hannes-hochreiner/kicad/models/CTS-FrequencyControls/CB3LV-3I-8M192000.step

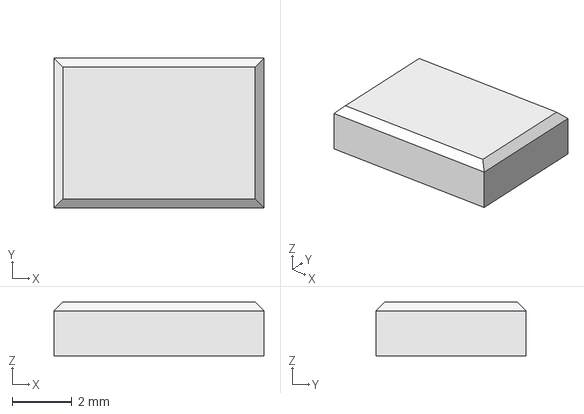
[picture p1: CAD file, 2021-01-03]
models/CTS-FrequencyControls/CB3LV-3I-8M192000.step
7.00 x 5.00 x 1.80 mm
