hannes-hochreiner/kicad/models/DiodesIncorporated/ZXCT1110W5-7.step

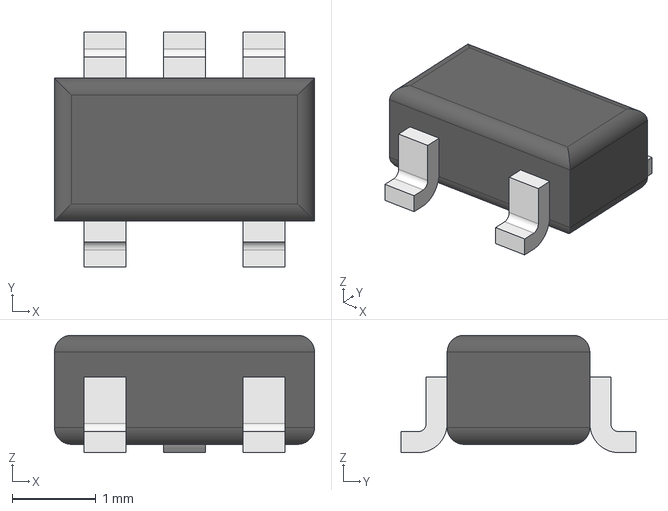
[picture p2: CAD file, 2020-11-29]
models/DiodesIncorporated/ZXCT1110W5-7.step
3.10 x 2.80 x 1.40 mm
