hannes-hochreiner/kicad/models/GCT/BD050-10.step

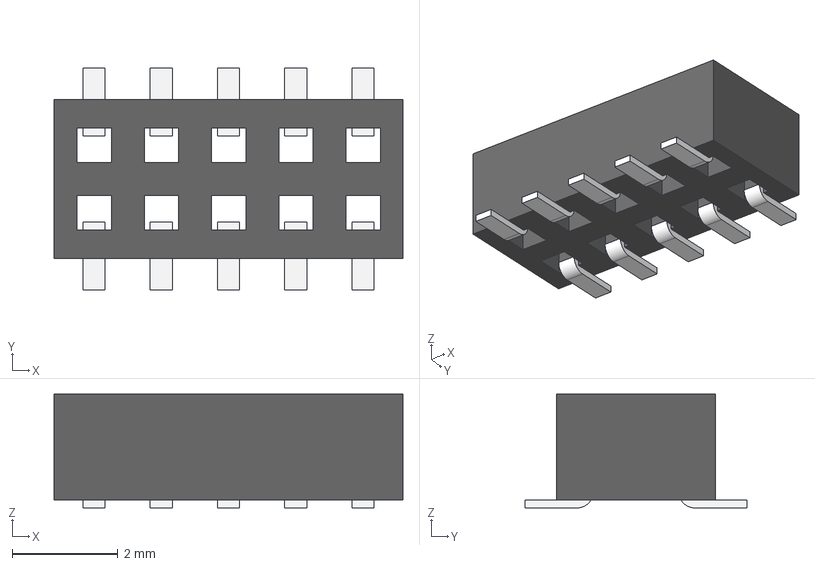
[picture p3: CAD file, 2021-06-03]
models/GCT/BD050-10.step
6.59 x 4.20 x 2.15 mm
