hannes-hochreiner/kicad/models/generic/crystal_3_2x1_5mm.step

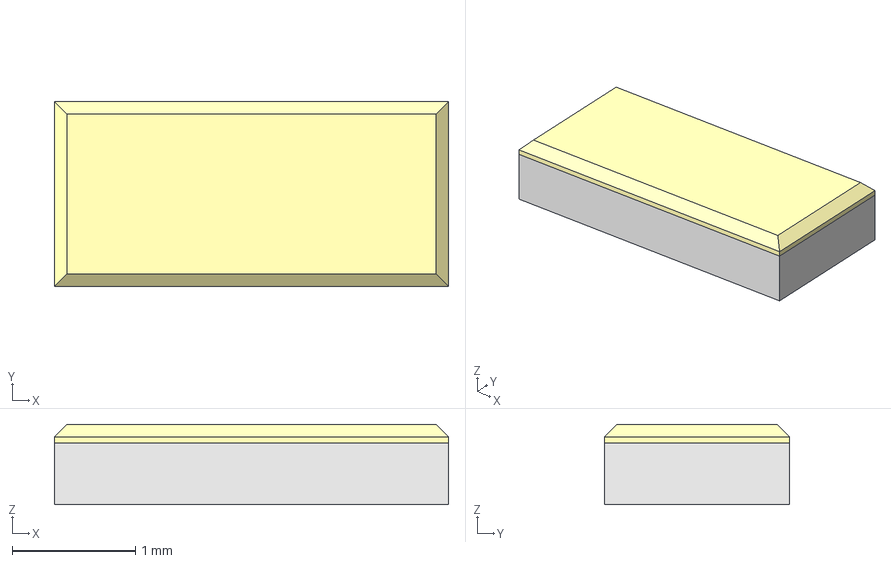
[picture p4: CAD file, 2021-06-03]
models/generic/crystal_3_2x1_5mm.step
3.20 x 1.50 x 0.65 mm
base
