hannes-hochreiner/kicad/models/HopeRF/RFM98.step

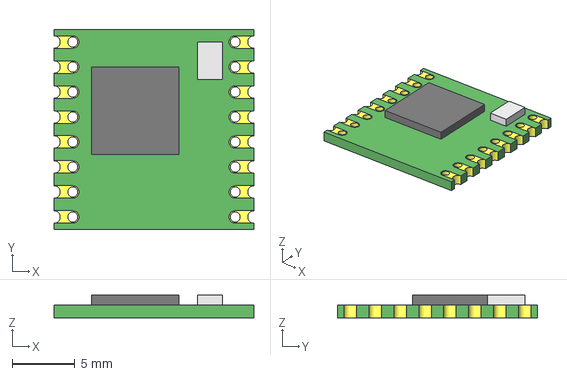
[picture p5: CAD file, 2019-08-25]
models/HopeRF/RFM98.step
16.0 x 16.0 x 1.80 mm
