hannes-hochreiner/kicad/models/Laird/BL651.step

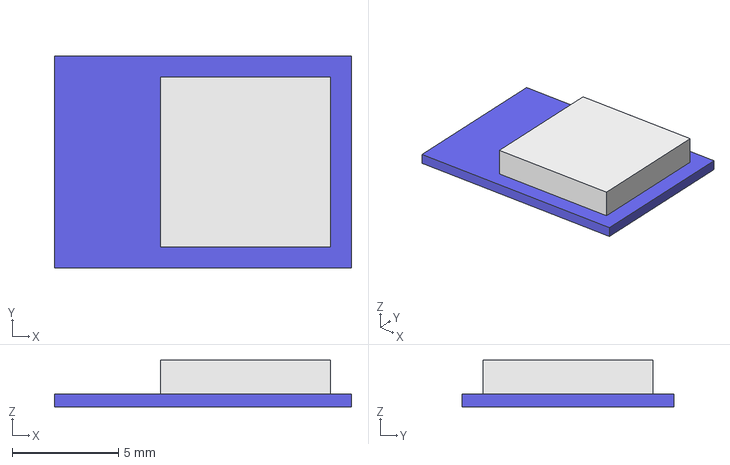
[picture p6: CAD file, 2020-10-26]
models/Laird/BL651.step
14.0 x 10.0 x 2.20 mm
