hannes-hochreiner/kicad/models/MicroCrystal/CM7V-T1A.step

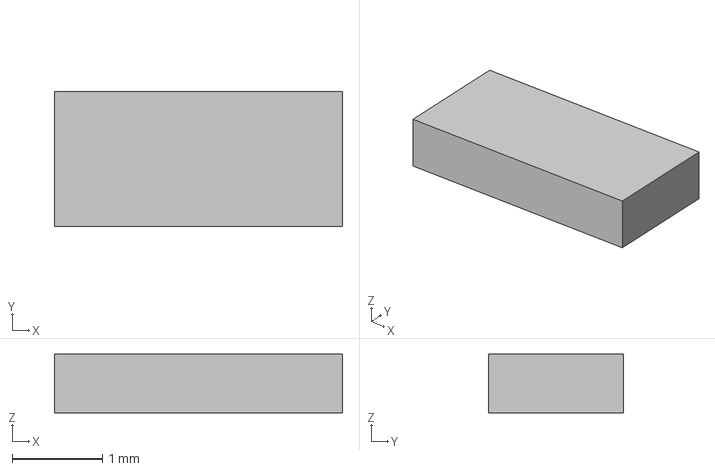
[picture p7: CAD file, 2020-11-29]
models/MicroCrystal/CM7V-T1A.step
3.20 x 1.50 x 0.65 mm
