hannes-hochreiner/kicad/models/SiTime/SIT1602BI-21-XXE-8.192000G.step

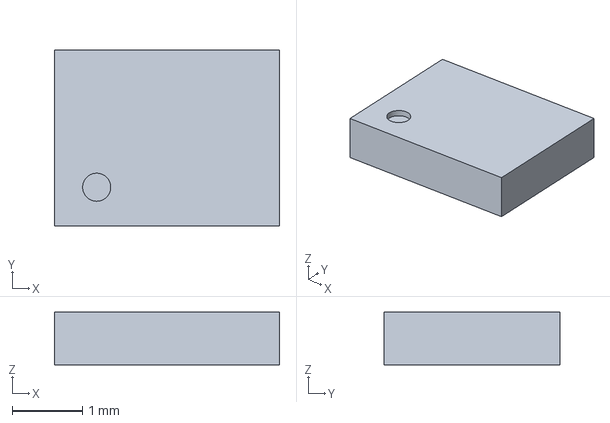
[picture p8: CAD file, 2020-11-29]
models/SiTime/SIT1602BI-21-XXE-8.192000G.step
3.20 x 2.50 x 0.75 mm
