hannes-hochreiner/kicad/models/STMicroelectronics/LSM303AGR.step

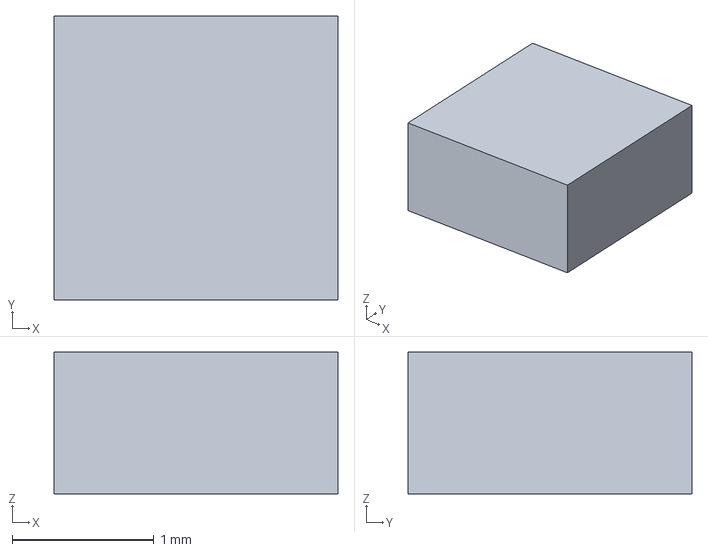
[picture p9: CAD file, 2021-06-03]
models/STMicroelectronics/LSM303AGR.step
2.00 x 2.00 x 1.00 mm
