hannes-hochreiner/kicad/models/TexasInstruments/TPS6031x.step

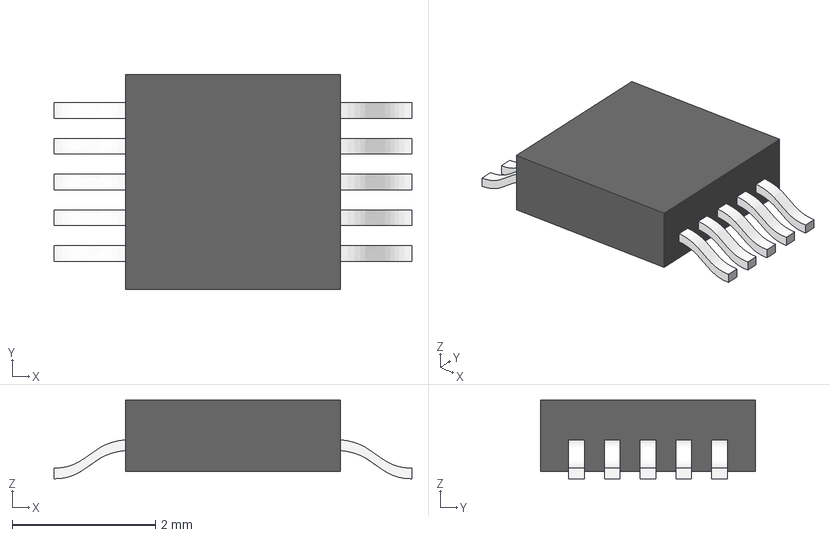
[picture p10: CAD file, 2021-06-03]
models/TexasInstruments/TPS6031x.step
5.00 x 3.00 x 1.10 mm
pin x 5
pin001 x 5
