hannes-hochreiner/kicad/models/GCT/BD050-06.step

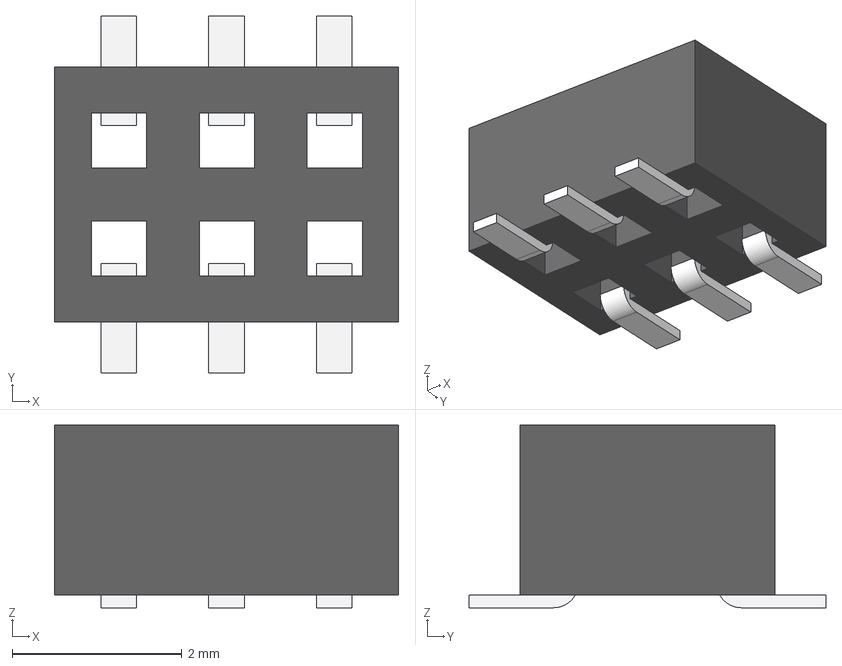
[picture p11: CAD file, 2021-06-03]
models/GCT/BD050-06.step
4.05 x 4.20 x 2.15 mm
