hannes-hochreiner/kicad/models/generic/R_2010.step

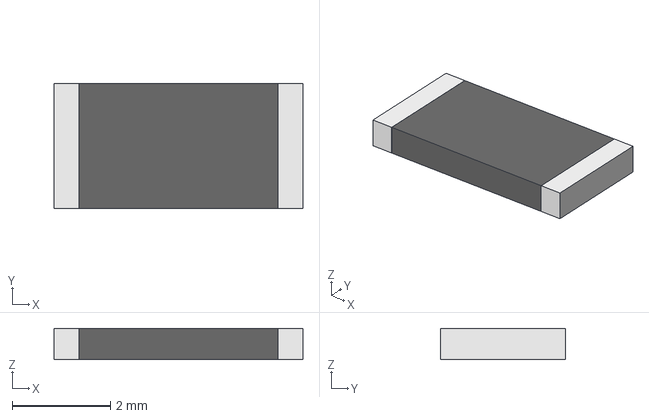
[picture p12: CAD file, 2021-01-03]
models/generic/R_2010.step
5.08 x 2.54 x 0.635 mm
