hannes-hochreiner/kicad/models/Memsic/MXC4005XC.step

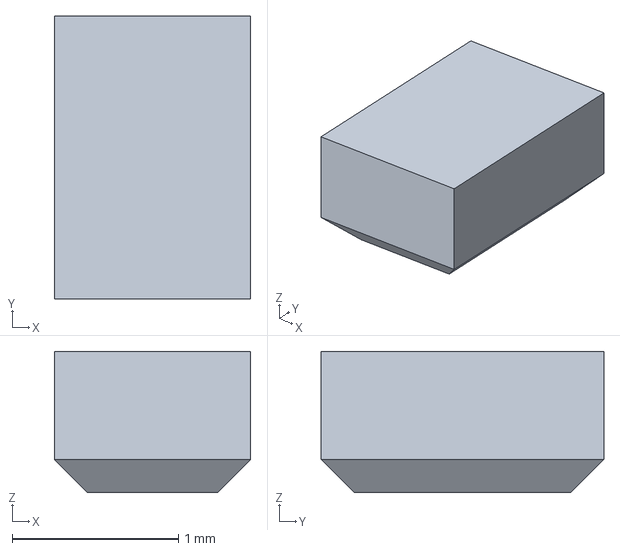
[picture p13: CAD file, 2021-06-03]
models/Memsic/MXC4005XC.step
1.18 x 1.70 x 0.85 mm
