hannes-hochreiner/kicad/models/Sensirion/SHTC3.step

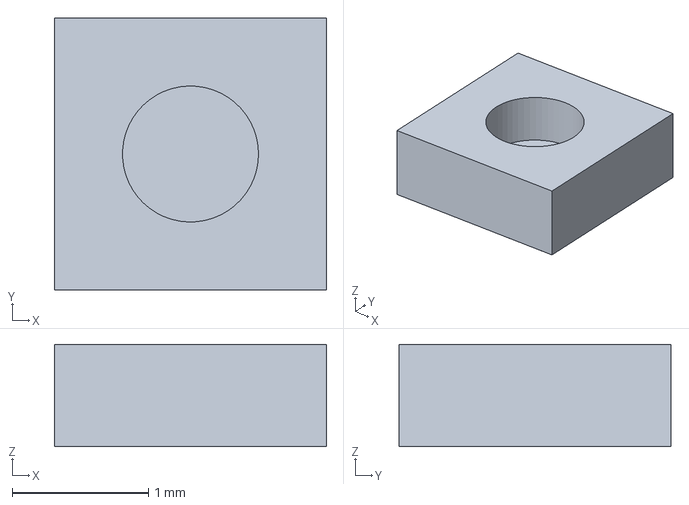
[picture p14: CAD file, 2020-11-29]
models/Sensirion/SHTC3.step
2.00 x 2.00 x 0.75 mm
