hannes-hochreiner/kicad/models/TexasInstruments/INA381-WSON.step

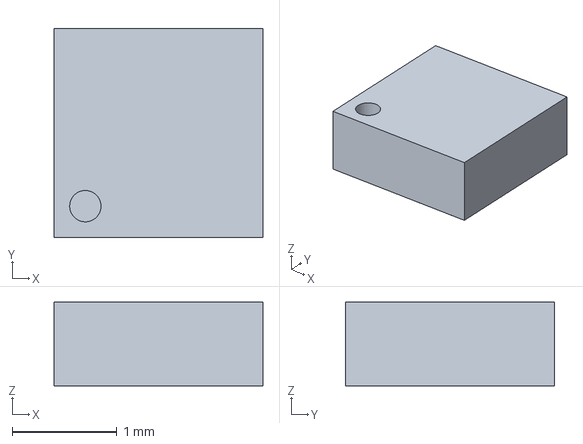
[picture p15: CAD file, 2021-01-03]
models/TexasInstruments/INA381-WSON.step
2.00 x 2.00 x 0.8 mm
