hannes-hochreiner/kicad/models/generic/R_0612.step

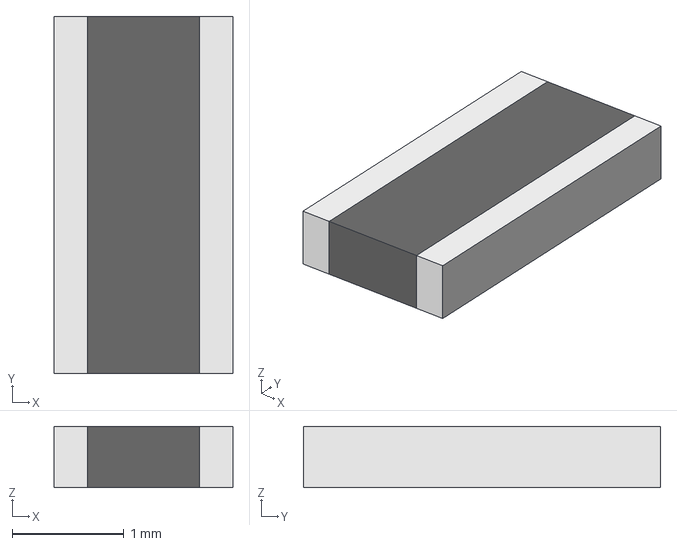
[picture p16: CAD file, 2021-01-03]
models/generic/R_0612.step
1.60 x 3.20 x 0.55 mm
