hannes-hochreiner/kicad/models/TexasInstruments/ADS131M04.step

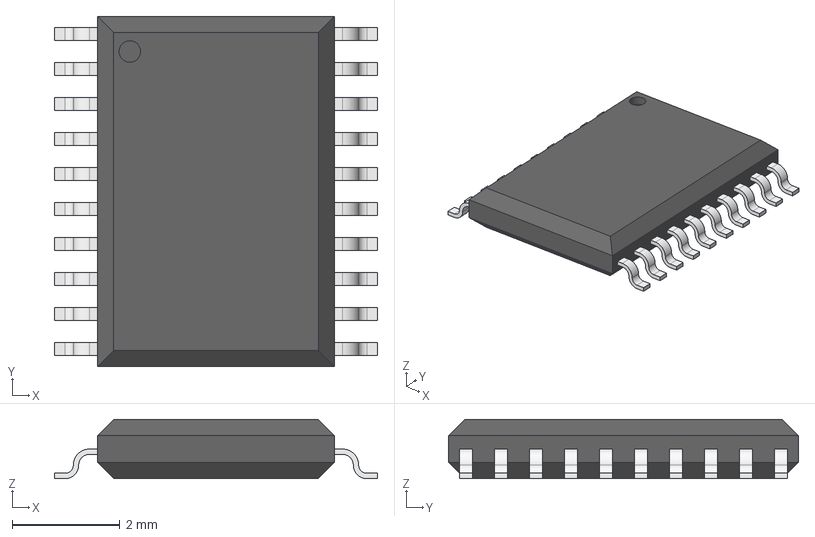
[picture p17: CAD file, 2021-01-03]
models/TexasInstruments/ADS131M04.step
6.00 x 6.50 x 1.10 mm
