hannes-hochreiner/kicad/models/generic/header_smd_2_54_2x5.step

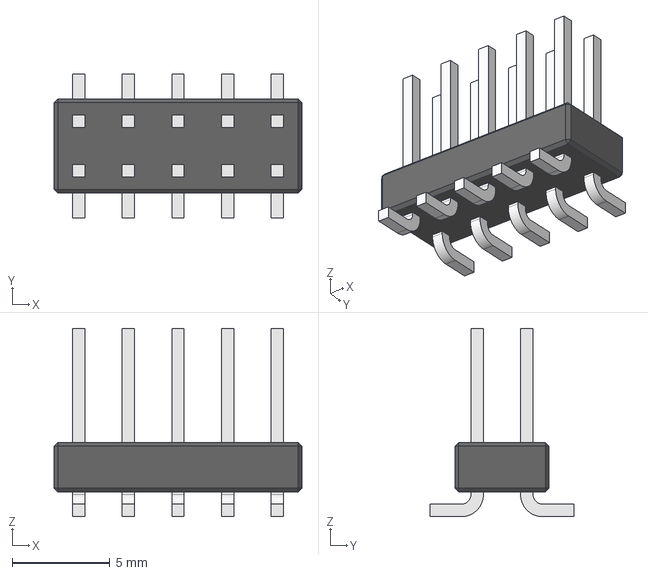
[picture p18: CAD file, 2021-01-03]
models/generic/header_smd_2_54_2x5.step
12.7 x 7.37 x 9.65 mm
