hannes-hochreiner/kicad/models/generic/header_smd_2_54_2x2.step

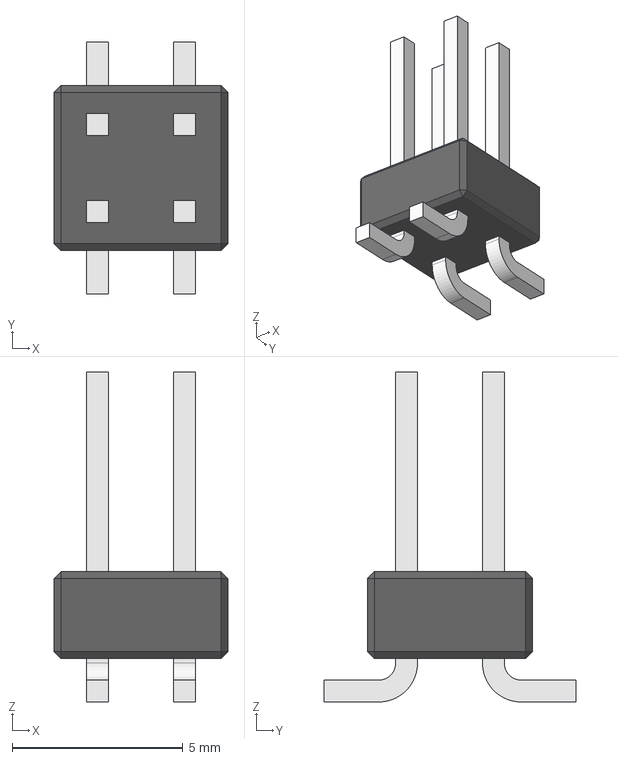
[picture p19: CAD file, 2021-01-03]
models/generic/header_smd_2_54_2x2.step
5.08 x 7.37 x 9.65 mm
