hannes-hochreiner/kicad/models/generic/Battery_AAA.step

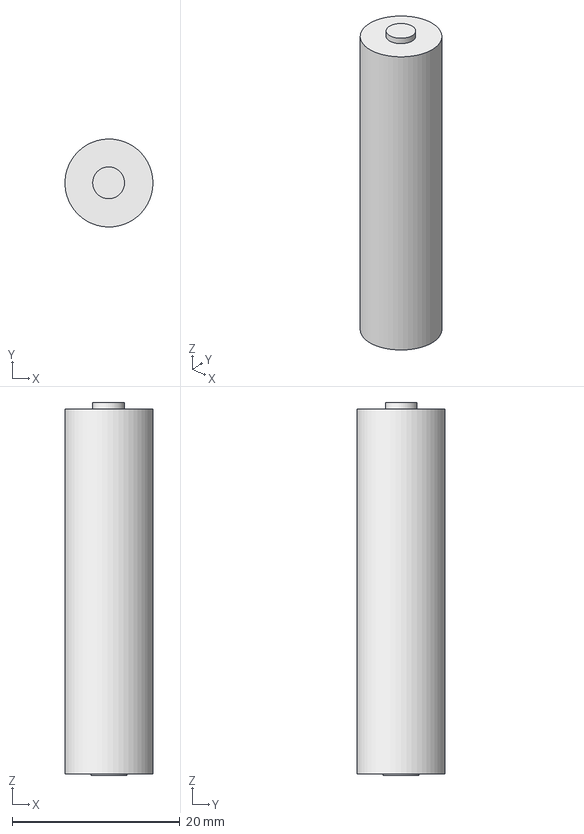
[picture p20: CAD file, 2020-11-29]
models/generic/Battery_AAA.step
10.5 x 10.5 x 44.5 mm
