hannes-hochreiner/kicad/models/generic/C_0603.step

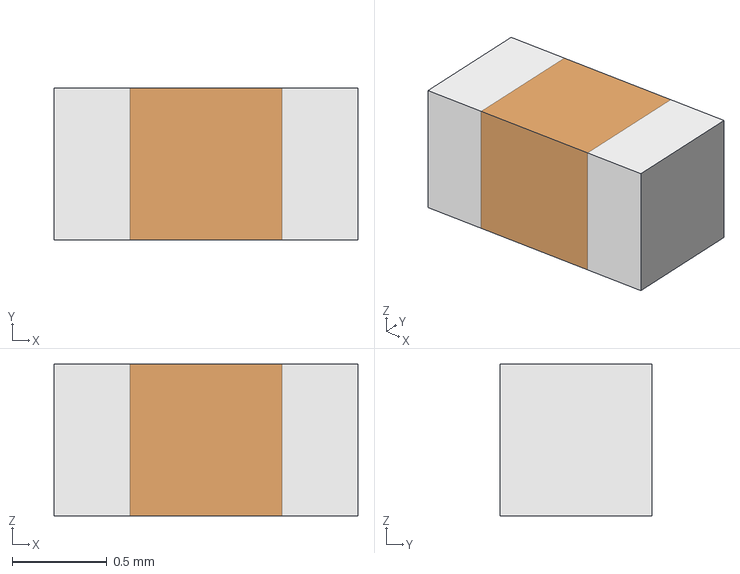
[picture p21: CAD file, 2020-11-29]
models/generic/C_0603.step
1.60 x 0.8 x 0.8 mm
