hannes-hochreiner/kicad/(list of files, cad)

Other CAD files:
models/generic/R_0603.step
models/AVX/009296002202906.FCStd
models/AVX/009296002202906.step
models/Amphenol/12401598E4_2A.step
models/CTS-FrequencyControls/CB3LV-3I-8M192000.FCStd
models/DiodesIncorporated/DMP2008UFG-7.FCStd
models/DiodesIncorporated/ZXCT1110W5-7.FCStd
models/GCT/BD050-06.FCStd
models/GCT/BD050-10.FCStd
models/Harwin/M50-3130545.FCStd
models/Harwin/M50-3130545.step
models/Harwin/M50-3150542R.fcstd
models/Harwin/M50-3150542R.step
models/HopeRF/RFM98.fcstd
models/Laird/BL651.fcstd
models/Memsic/MMC5603NJ.FCStd
models/Memsic/MXC4005XC.FCStd
models/MicroCrystal/CM7V-T1A.FCStd
models/STMicroelectronics/LSM303AGR.FCStd
models/Sensirion/SHT4x.FCStd
models/Sensirion/SHTC3.FCStd
models/SiTime/SIT1602BI-21-XXE-8.192000G.FCStd
models/TexasInstruments/ADS131M04.FCStd
models/TexasInstruments/INA381-WSON.FCStd
models/TexasInstruments/TPS6031x.FCStd
models/generic/Battery_AAA.FCStd
models/generic/C_0603.FCStd
models/generic/R_0603.FCStd
models/generic/R_0612.FCStd
models/generic/R_2010.FCStd
models/generic/crystal_3_2x1_5mm.FCStd
models/generic/header_smd_2_54_2x2.FCStd
models/generic/header_smd_2_54_2x5.FCStd
