hannes-hochreiner/kicad/(commit log)

2019-08-25 added RFM98
    [RFM98.fcstd, RFM98.sch, RFM98.step]
2019-08-26 added an STM MCU
    [STM32L021K4T6.sch]
2020-05-23 added basic layout for STM32G070KBT6
    [STM32G070KBT6.sch, STM32L021K4T6.sch]
2020-10-20 added sensor
2020-10-26 added new footprints, symbols, and models
    [BL651.fcstd, BL651.step, M50-3150542R.fcstd, M50-3150542R.step]
2020-10-27 added new parts
    [009296002202906.FCStd, 009296002202906.step]
2020-11-29 added new elements
    [Battery_AAA.FCStd, Battery_AAA.step, CM7V-T1A.FCStd, CM7V-T1A.step, C_0603.FCStd, C_0603.step, DMP2008UFG-7.FCStd, DMP2008UFG-7.step]
2020-11-29 fixed TI library
    [ZXCT1110W5-7.FCStd, ZXCT1110W5-7.step]
2021-01-03 add new symbols, models, and footprints
    [ADS131M04.FCStd, ADS131M04.step, CB3LV-3I-8M192000.FCStd, CB3LV-3I-8M192000.step, INA381-WSON.FCStd, INA381-WSON.step, R_0612.FCStd, R_0612.step]
2021-06-03 add Memsic sensors
    [MMC5603NJ.FCStd, MMC5603NJ.step, MXC4005XC.FCStd, MXC4005XC.step]
2022-05-16 update footprint link
2022-05-16 add footprint
